ast/yaesu-ah4/docs/images/pecab-pe120b-inside.jpg

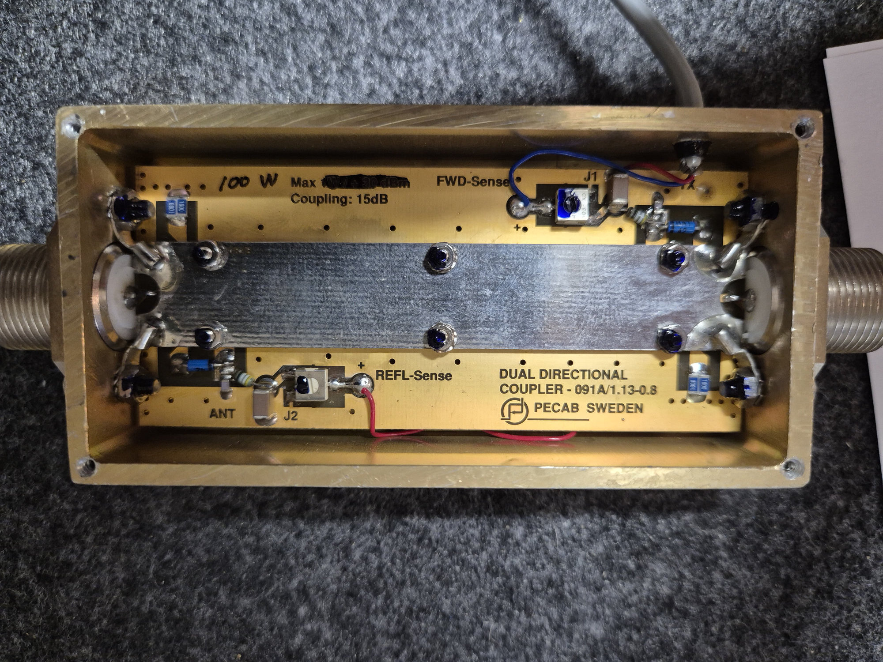
docs/images/pecab-pe120b-inside.jpg
