ast/yaesu-ah4/docs/images/pecab-pe120b-label.jpg

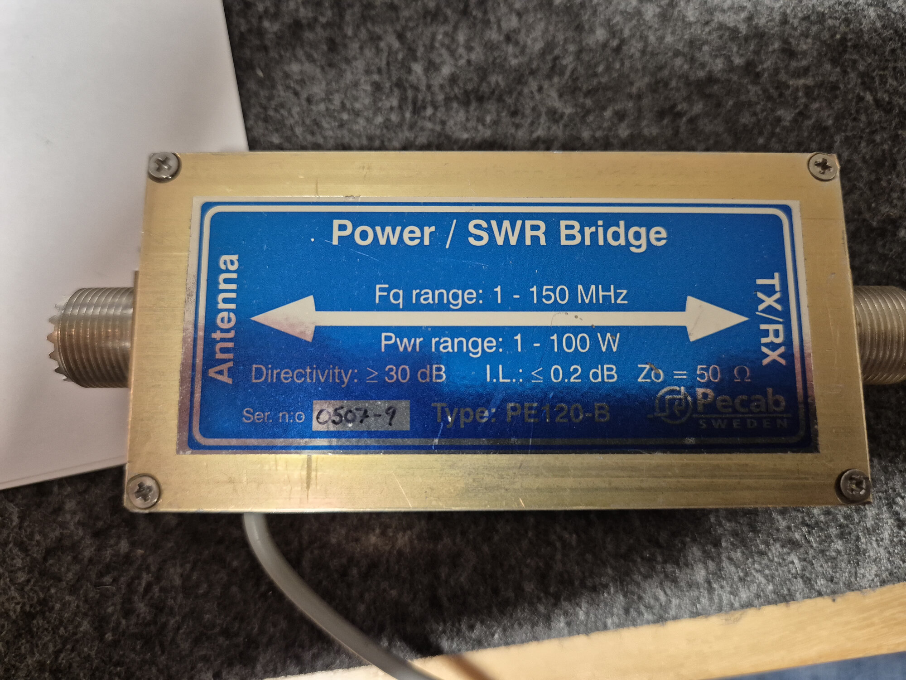
docs/images/pecab-pe120b-label.jpg
