ast/yaesu-ah4/docs/AH-4 Brochure.pdf

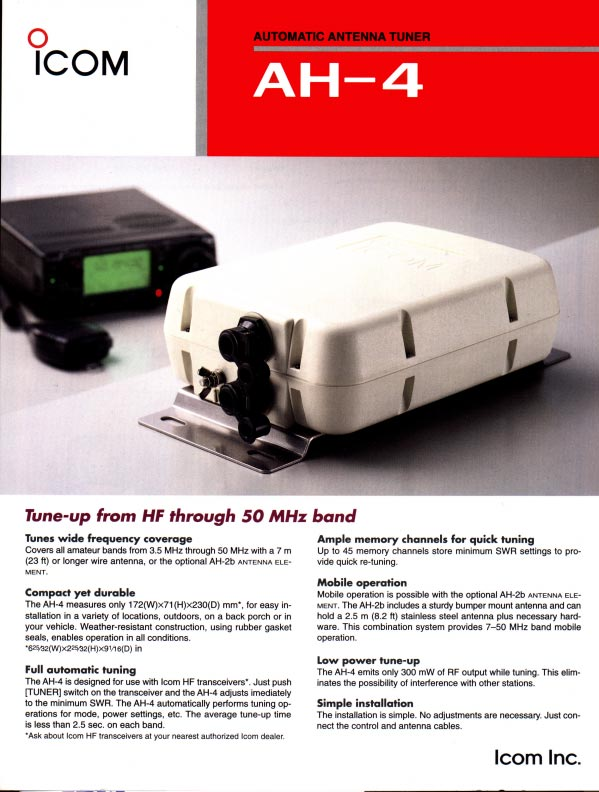
[picture p3: page 1]
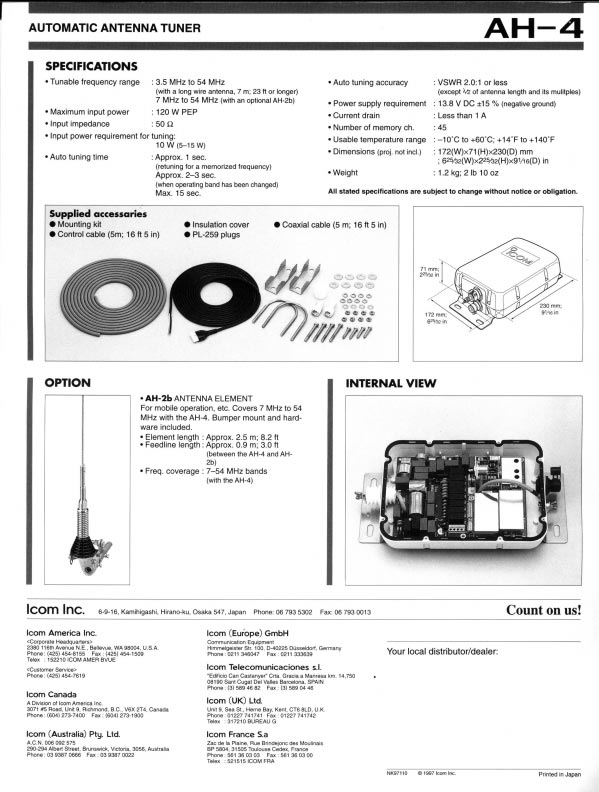
[picture p4: page 2]
