ast/yaesu-ah4/(commit log)

2026-10-10 Protocol bench: Teensy 2.0 FC-40 emulator, CAT session tool, design notes
2026-10-10 Add Pecab PE120-B bridge photos and power measurement plan
2026-10-11 Coupler calibration, ADC power logging in the emulator, stale host-line guard
    [coupler.csv]
2026-10-11 Wiring table with Teensy silkscreen labels; no VIN on Teensy 2.0
2026-10-11 Session logger survives USB re-enumeration; RESET input pull-up
    [session.py]
2026-10-11 TX INH is ignored by the FT-891 in EXTERNAL mode, wiring verified
2026-10-11 TX INH idles at 0 V in EXTERNAL mode
2026-10-12 LAMP mode support: SENSE on a Teensy pin, band data logging, TX INH readback
2026-10-12 README: SENSE on Teensy D0, new emulator commands
2026-10-12 README: AH-4 wiring rows, TX INH polarity
2026-10-12 Tune carrier power per mode
2026-10-12 Band sweep results with the real antenna
2026-10-12 Session logger: CAT watchdog reopens a stalled CP2105 port
    [session.py]
2026-10-12 SENSE must be a hard ground strap
2026-10-12 Cleanup: adapter-only firmware (ah4_adapter), README/CLAUDE/design-notes rewritten for the final design
    - firmware/tuner_emu removed; firmware/ah4_adapter is the bridge only, with
    the F1-start sequence as default and the classic F2-start behind f1start 0
    - instrumentation: timestamped line events, state names, TUNE summary line
    per cycle, PWR samples, STATUS; host commands trimmed to what debugging needs
    - session.py: CAT watchdog pauses while the radio transmits
    - README rewritten as adapter documentation; design-notes section 3 is the spec
2026-10-12 Review fixes: A0 before logging, edge-qualified KEY, F2 during reset pulse, stale A1 flag, ah4Finish helper; logger: ID; probe watchdog, FIFO check, 4800 default, sleep guard
    [ah4_adapter.ino, session.py]
2026-10-12 README: operating manual (settings, power-up order, how to tune, troubleshooting)
